ayaskant007/Meridian-87/images/pcb_bottom.png

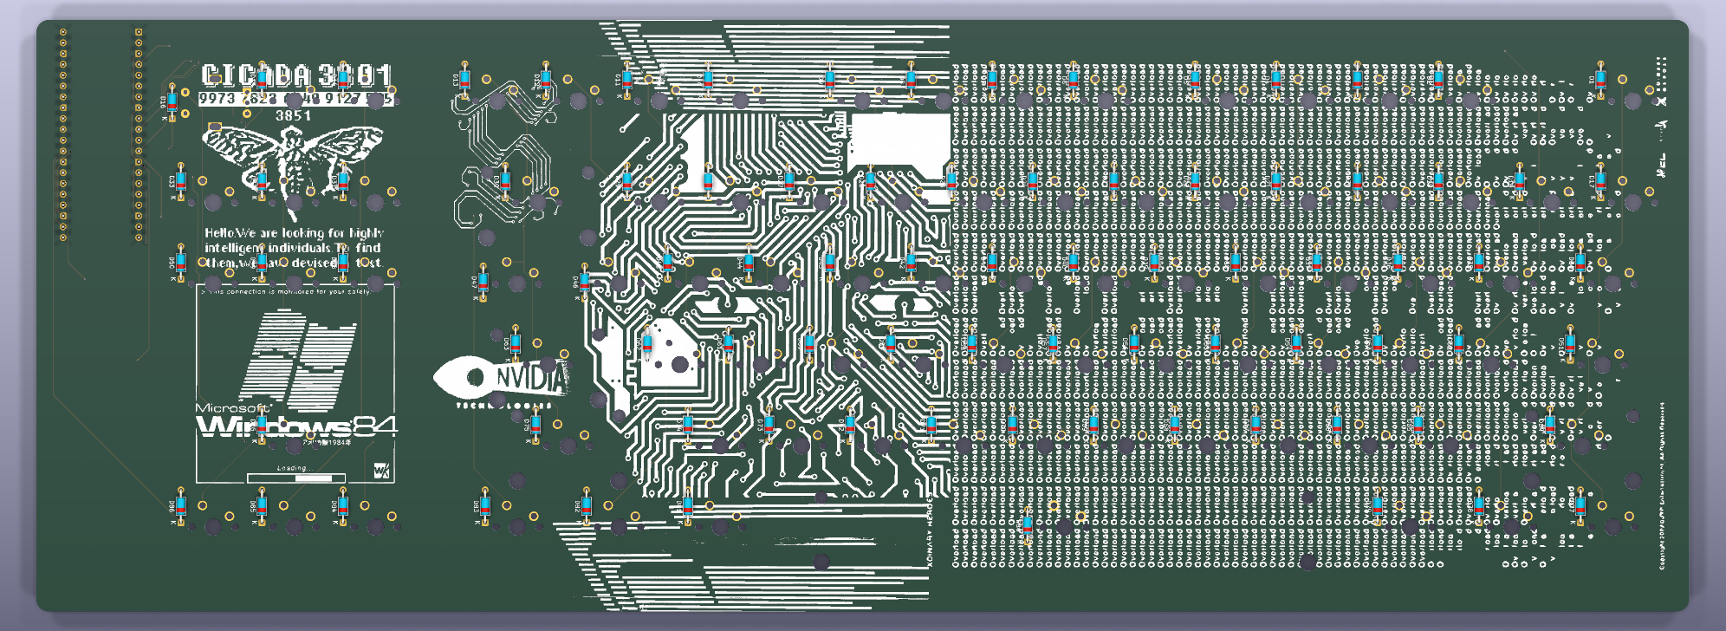
images/pcb_bottom.png
