ayaskant007/Meridian-87/BOM.csv

Name | Purpose | Quantity | Total Cost (USD) | Link | Distributor | Total Cost (INR) | Notes
PCB (2-layer, 1.6 mm FR4, black mask, HASL, 388.12 x 138.90 mm) | Main keyboard PCB; MOQ is 5, 1 used, 4 spare | 5 | 28.00 | https://cart.jlcpcb.com/quote | JLCPCB | 2630.04 | JLCONE desktop price (web price $30.00). Upload production/gerbers.zip. Checked 2026-11-10.
PCB shipping to India (E-POST) | Delivery of the PCBs | 1 | 22.32 | https://cart.jlcpcb.com/quote | JLCPCB | 2096.52 | 10-18 business days, 1.06 kg. Any Indian customs duty charged on delivery is not included.
Raspberry Pi Pico (original, without headers) | RP2040 microcontroller that runs QMK | 1 | 4.09 | https://robu.in/product/raspberry-pi-pico/ | Robu | 384.00 | In stock. Footprint is Module:RaspberryPi_Pico_Common_THT.
Male pin header 1x40, 2.54 mm | Solder the Pico to the PCB (break into 2 x 20) | 2 | 0.17 | https://robu.in/product/1x40-berg-strip-male-connector/ | Robu | 16.00 | Rs 8 each.
1N4148 switching diode, DO-35 through-hole (onsemi) | One per key + encoder press for the 6x17 matrix (86 used) | 100 | 3.29 | https://robu.in/product/1n4148-onsemi-100v-1v10ma-4ns-200ma-do-35-switching-diodes-rohs/ | Robu | 309.00 | Rs 3.09 each. Fits D_DO-35_SOD27_P7.62mm_Horizontal. Stripe (cathode) goes on the square pad, matching the silkscreen bar.
EC11 rotary encoder with push switch, 20 mm knurled shaft (Hongyan EC11H 7CE20P1ZY20) | Volume knob in the Pause position | 1 | 0.62 | https://robu.in/product/hongyan-ec11h-7ce20p1zy20-rotary-encoder-with-push-button-switch-vertical-plug-in-5-pin/ | Robu | 58.00 | 20 pulses / 20 detents (firmware resolution 4). 5 pins + 2 mounting tabs. Bare part, not a KY-040 module.
Encoder knob, 15 mm OD, 6 mm knurled bore | Cap for the encoder | 1 | 0.20 | https://robu.in/product/potentiometer-knob-rotary-switch-cap-black-color-pack-of-5-pcs/ | Robu | 19.00 | Keep the knob 17 mm or smaller so it clears the Scroll Lock keycap.
Micro-USB data cable, 1 m (USB-A to Micro-B) | Connects the keyboard to the PC | 1 | 0.52 | https://robu.in/product/micro-usb-a-to-micro-b-cable-120cm/ | Robu | 49.00 | Data + power. The Pico has a Micro-USB port.
Outemu Peach v3 silent linear switches (pack of 10) | Key switches (85 used, 15 spare) | 10 | 17.03 | https://neomacro.in/products/outemu-peach-v3-silent | Neomacro | 1600.00 | Rs 160 per pack. 40 g, factory lubed. Soldered build: PCB accepts 3-pin and 5-pin. Free shipping above Rs 1,500.
Glorious GOAT screw-in PCB stabilizers | Stabilize Backspace 2u, Enter 2.25u, LShift 2.25u, RShift 2.75u and the 7u spacebar | 1 | 7.44 | https://meckeys.com/shop/accessories/keyboard-accessories/more/glorious-goat-stabilizers/ | Meckeys | 699.30 | Diwali price (regular Rs 999). Contains 5x 2U, 1x 6.25U, 1x 7U wires and 12 housings. Use 4x 2U + the 7U wire.
Keychron Cherry profile double-shot PBT full keycap set - Camel (219 keys) | Keycaps, including the Tsangan bottom row | 1 | 31.61 | https://credkeys.com/products/cherry-profile-double-shot-pbt-full-set-keycaps-camel | Credkeys | 2969.10 | Includes 2x 1.5U R1 Ctrl, 2x 1.5U R1 Alt, 1U R1 Win and Fn, and a 7U R1 spacebar. Tax included; shipping is calculated at checkout and is not included.
Solder wire 60/40, 1.0 mm, 50 g (Noel) | Consumable for ~390 solder joints (skip if you have solder) | 1 | 4.01 | https://robu.in/product/solder-wire-1-00mm-50gm/ | Robu | 377.00 | Also keeps the Robu order above Rs 999 for free delivery.
Flux paste, 10 g (Noel) | Consumable (skip if you have flux) | 1 | 0.22 | https://robu.in/product/noel-flux-soldering-paste-10g/ | Robu | 21.00
Clear self-adhesive rubber bumper feet (100 pcs) | Anti-slip feet under the case (optional) | 1 | 1.18 | https://www.amazon.in/dp/B0F7FKDTF9 | Amazon.in | 111.00 | Free delivery as listed on 2026-11-10.
Case bottom, 3D printed (CAD/Case_Bottom.step) | Case | 1 |  |  | Printing Legion |  | Not priced (printed by Printing Legion). 400.12 x 150.9 x 36.4 mm; needs a 400 mm bed or a split print. See README for required fixes before printing.
Switch plate, 3D printed, 1.5 mm (Plate_Reference body in CAD/TKL_CASE.step) | Holds the switches; sits on the case rim | 1 |  |  | Printing Legion |  | Not priced (printed by Printing Legion). Must be exactly 1.5 mm thick. Case_Top.step is empty; export the Plate_Reference body instead.
Double-sided tape (VHB) | Holds the plate on the case rim | 1 |  |  | Self-sourced |  | Not priced (sourced by you).
Shipping - Robu, Meckeys, Neomacro |  |  | 0.00 |  |  | 0.00 | Robu free above Rs 999 (order is Rs 1,233); Meckeys free shipping; Neomacro free above Rs 1,500.
Shipping - Credkeys |  |  |  |  |  |  | Calculated at checkout; not included.
TOTAL (excl. 3D prints, tape, Credkeys shipping, customs) |  |  | 120.72 |  |  | 11338.96 | USD at Rs 93.93/USD (open.er-api.com, 2026-11-10)
