ayaskant007/Meridian-87/CAD/Components/ESP32-S3-DEVKITC-1-N8R2--3DModel-STEP-56544.STEP

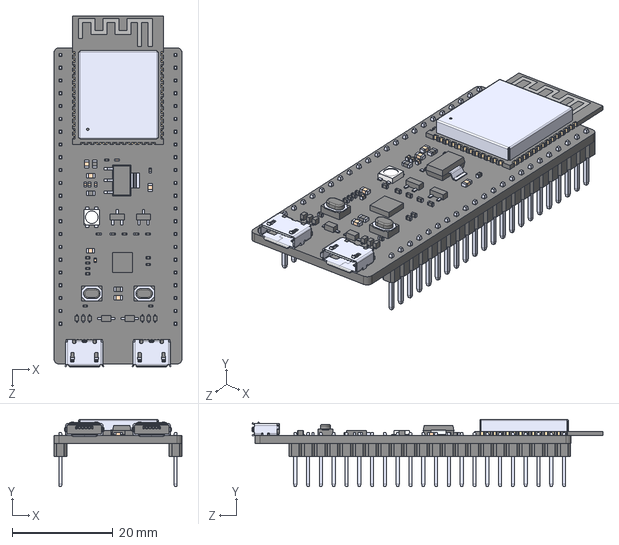
[picture p23: CAD file, 2026-06-04]
CAD/Components/ESP32-S3-DEVKITC-1-N8R2--3DModel-STEP-56544.STEP
25.4 x 13.4 x 69.6 mm
