ayaskant007/Meridian-87/production/Case_Bottom.step

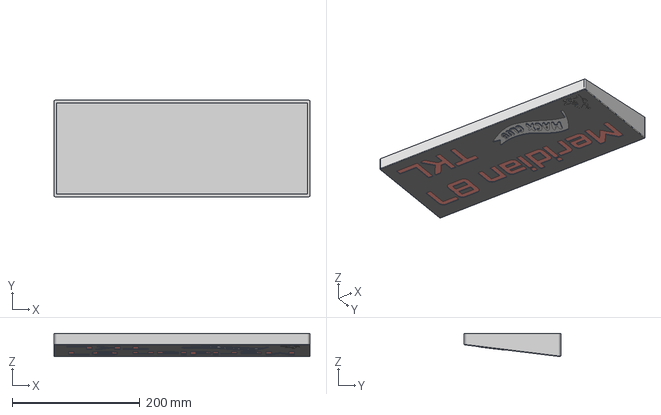
[picture p24: CAD file, 2026-11-10]
production/Case_Bottom.step
400.1 x 150.9 x 36.4 mm
