ayaskant007/Meridian-87/CAD/Components/plate-2026-06-03T05_43_15.664Z.dxf

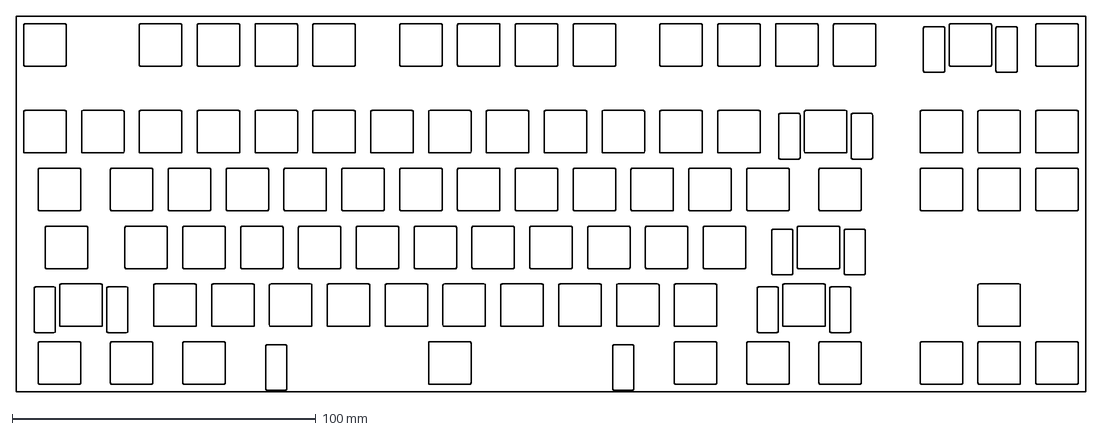
[picture p25: CAD file, 2026-06-04]
CAD/Components/plate-2026-06-03T05_43_15.664Z.dxf
352.4 x 123.8 mm
