ayaskant007/Meridian-87/CAD/plate-2026-06-17T05_24_56.389Z.dxf

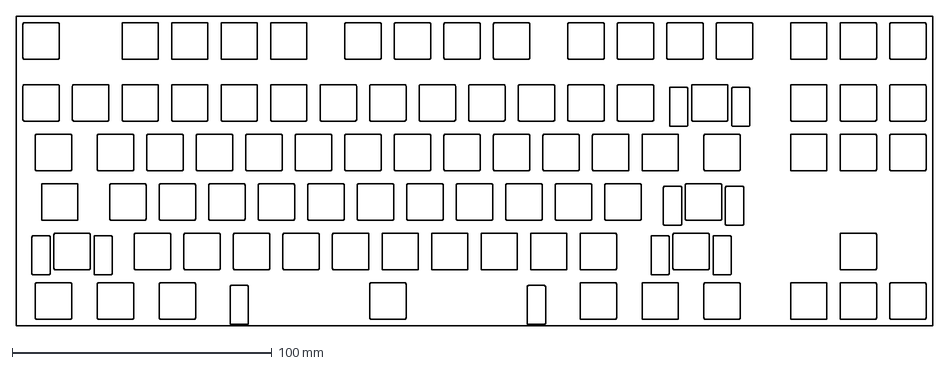
[picture p26: CAD file, 2026-11-10]
CAD/plate-2026-06-17T05_24_56.389Z.dxf
352.4 x 119.1 mm
