ayaskant007/Meridian-87/(list of files, cad)

Other CAD files:
CAD/Case_Top.step
production/Case_Top.step
CAD/TKL_CASE.step
CAD/TKL_CASE.f3z
