ayaskant007/Meridian-87/production/Meridian87_schematic.pdf

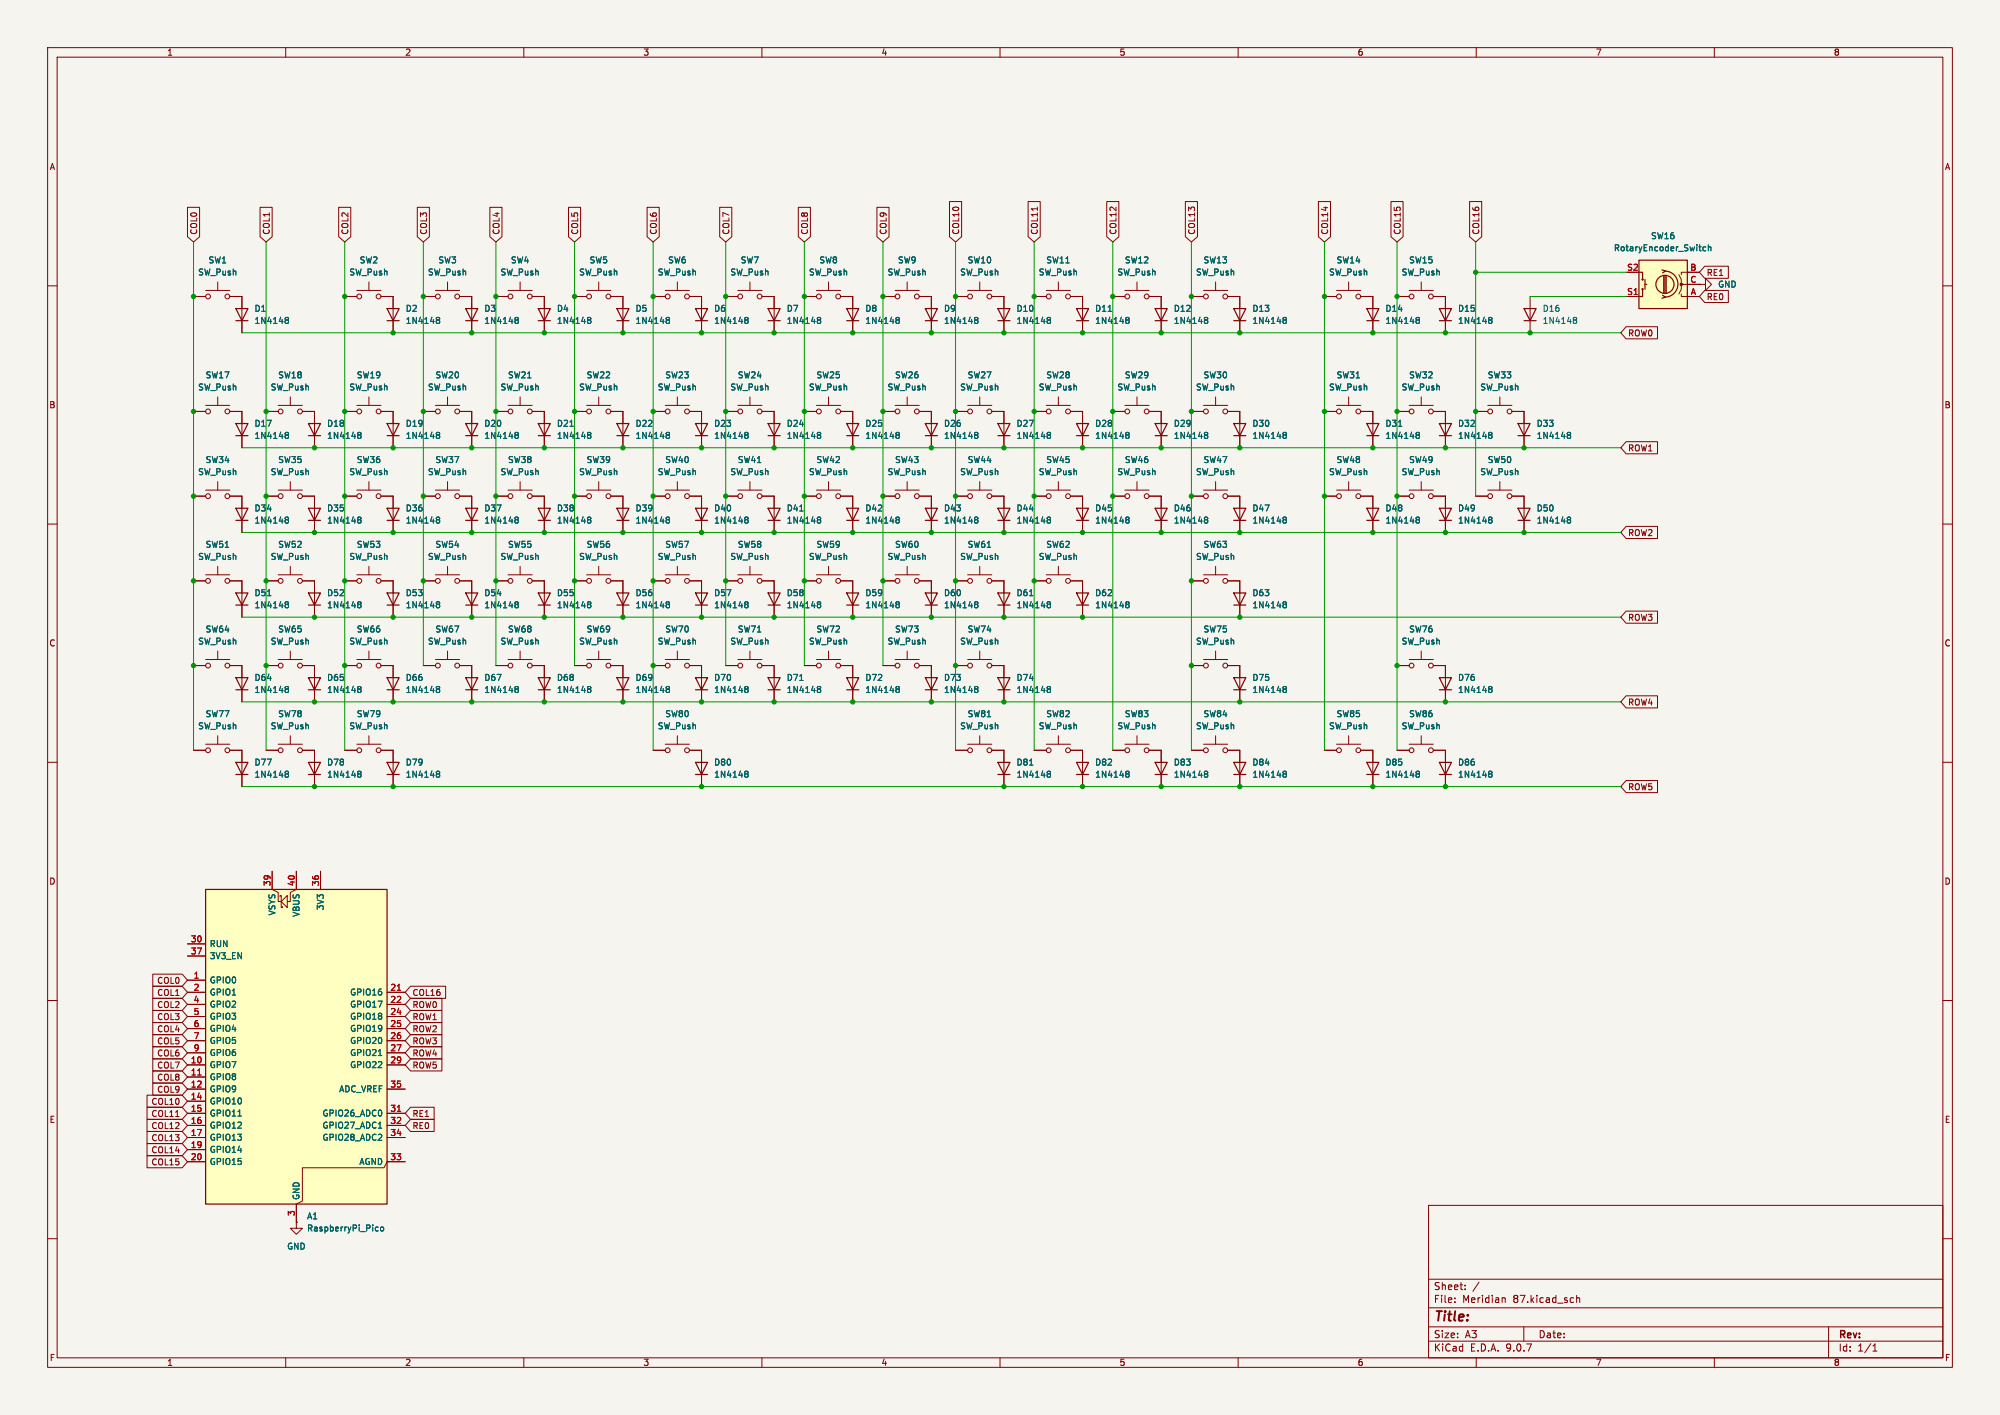
[picture p27: page 1]
