ayaskant007/Meridian-87/FIRMWARE/keymaps/via/keymap.c

#include QMK_KEYBOARD_H

enum layers { _BASE, _FN, _L2, _L3 };

const uint16_t PROGMEM keymaps[][MATRIX_ROWS][MATRIX_COLS] = {
    [_BASE] = LAYOUT(
        KC_ESC,           KC_F1,   KC_F2,   KC_F3,   KC_F4,   KC_F5,   KC_F6,   KC_F7,   KC_F8,   KC_F9,   KC_F10,  KC_F11,  KC_F12,      KC_PSCR, KC_SCRL, KC_MUTE,
        KC_GRV,  KC_1,    KC_2,    KC_3,    KC_4,    KC_5,    KC_6,    KC_7,    KC_8,    KC_9,    KC_0,    KC_MINS, KC_EQL,  KC_BSPC,     KC_INS,  KC_HOME, KC_PGUP,
        KC_TAB,  KC_Q,    KC_W,    KC_E,    KC_R,    KC_T,    KC_Y,    KC_U,    KC_I,    KC_O,    KC_P,    KC_LBRC, KC_RBRC, KC_BSLS,     KC_DEL,  KC_END,  KC_PGDN,
        KC_CAPS, KC_A,    KC_S,    KC_D,    KC_F,    KC_G,    KC_H,    KC_J,    KC_K,    KC_L,    KC_SCLN, KC_QUOT,          KC_ENT,
        KC_LSFT,          KC_Z,    KC_X,    KC_C,    KC_V,    KC_B,    KC_N,    KC_M,    KC_COMM, KC_DOT,  KC_SLSH,          KC_RSFT,              KC_UP,
        KC_LCTL, KC_LGUI, KC_LALT,                            KC_SPC,                             KC_RALT, MO(_FN), KC_RCTL,              KC_LEFT, KC_DOWN, KC_RGHT
    ),

    [_FN] = LAYOUT(
        QK_BOOT,          KC_BRID, KC_BRIU, _______, _______, KC_MPRV, KC_MPLY, KC_MNXT, KC_MSTP, KC_MUTE, KC_VOLD, KC_VOLU, _______,     _______, KC_PAUS, KC_MPLY,
        _______, _______, _______, _______, _______, _______, _______, _______, _______, _______, _______, _______, _______, _______,     _______, _______, _______,
        _______, _______, _______, _______, _______, _______, _______, _______, _______, _______, _______, _______, _______, _______,     _______, _______, _______,
        _______, _______, _______, _______, _______, _______, _______, _______, _______, _______, _______, _______,          _______,
        _______,          _______, _______, _______, _______, _______, NK_TOGG, _______, _______, _______, _______,          _______,              _______,
        _______, GU_TOGG, _______,                            _______,                            _______, _______, _______,              _______, _______, _______
    ),

    [_L2] = LAYOUT(
        _______,          _______, _______, _______, _______, _______, _______, _______, _______, _______, _______, _______, _______,     _______, _______, _______,
        _______, _______, _______, _______, _______, _______, _______, _______, _______, _______, _______, _______, _______, _______,     _______, _______, _______,
        _______, _______, _______, _______, _______, _______, _______, _______, _______, _______, _______, _______, _______, _______,     _______, _______, _______,
        _______, _______, _______, _______, _______, _______, _______, _______, _______, _______, _______, _______,          _______,
        _______,          _______, _______, _______, _______, _______, _______, _______, _______, _______, _______,          _______,              _______,
        _______, _______, _______,                            _______,                            _______, _______, _______,              _______, _______, _______
    ),

    [_L3] = LAYOUT(
        _______,          _______, _______, _______, _______, _______, _______, _______, _______, _______, _______, _______, _______,     _______, _______, _______,
        _______, _______, _______, _______, _______, _______, _______, _______, _______, _______, _______, _______, _______, _______,     _______, _______, _______,
        _______, _______, _______, _______, _______, _______, _______, _______, _______, _______, _______, _______, _______, _______,     _______, _______, _______,
        _______, _______, _______, _______, _______, _______, _______, _______, _______, _______, _______, _______,          _______,
        _______,          _______, _______, _______, _______, _______, _______, _______, _______, _______, _______,          _______,              _______,
        _______, _______, _______,                            _______,                            _______, _______, _______,              _______, _______, _______
    )
};

#if defined(ENCODER_MAP_ENABLE)
const uint16_t PROGMEM encoder_map[][NUM_ENCODERS][NUM_DIRECTIONS] = {
    [_BASE] = {ENCODER_CCW_CW(KC_VOLD, KC_VOLU)},
    [_FN]   = {ENCODER_CCW_CW(KC_MPRV, KC_MNXT)},
    [_L2]   = {ENCODER_CCW_CW(_______, _______)},
    [_L3]   = {ENCODER_CCW_CW(_______, _______)},
};
#endif
