ayaskant007/Meridian-87/(commit log)

2026-06-04 Made & Added PCB and some footprints
    [Meridian 87.kicad_pcb, Meridian 87.kicad_sch, freerouting.dsn, plate-2026-06-03T05_43_15.664Z.dxf]
2026-06-04 Added new MCU SYMBOLS & FOOTPRINTS
    [ESP32-S3-DEVKITC-1-N8R2--3DModel-STEP-56544.STEP, Meridian 87.kicad_sch]
2026-11-10 Add Meridian 87 firmware, verified BOM and build docs
    - Replace the Xeon Horizon macropad firmware with a QMK definition
    generated from the PCB: 6x17 COL2ROW matrix on GP0-GP22, EC11 encoder
    on GP26/GP27, default and VIA keymaps, VIA definition and prebuilt UF2s
    - Rewrite BOM.csv with every part needed for a full build, Indian
    sources and links checked 2026-11-10, INR and USD totals; PCB moved to
    JLCPCB (desktop price + E-POST) from the Lion Circuits quote
    - Add README with flashing, Fn layer, pin map, case fixes and assembly
    order, plus SOURCING.md comparing suppliers
    - Add PCB renders and a schematic PDF
    - Reorganise into PCB/, CAD/ and production/, add the TKL case CAD and
    dro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
    [BOM.csv, Case_Bottom.step, Case_Top.step, ESP32-S3-DEVKITC-1-N8R2--3DModel-STEP-56544.STEP, Meridian 87.kicad_pcb, Meridian 87.kicad_sch, TKL_CASE.f3z, TKL_CASE.step]
